AdAvAn/WaterLeak/(list of files, drawings)

Other design files:
pcb/PCB-print.eprj
pcb/PCB-print.json
