AdAvAn/WaterLeak/Buttons/HeaterButton.py

import Resources.Settings as Settings
from Buttons.ButtonPort import ButtonPort
from Buzzers.Buzzers import Buzzers
from Logging.AppLogger import AppLogger
from Heater.HeaterPowerSwith import HeaterPowerSwith
from State.States import States

class HeaterButton:
    
    def __init__(self, states: States, leak_sensors=None):
        self.buzzer = Buzzers()
        self.logger = AppLogger()
        self._port = ButtonPort(Settings.HOCB_PIN, self.callback)
        self.heater = HeaterPowerSwith(states)
        self.leak_sensors = leak_sensors 
        
    def start(self):
        self._port.start()

    def stop(self):
        self._port.stop()

    def callback(self, event: str) -> None:
        if event == ButtonPort.SHORT_EVENT_ID:
            self._short_handler()
        elif event == ButtonPort.LONG_EVENT_ID:
            self._long_handler()

    def _short_handler(self) -> None:
        # If alarm is active, any button press clears the alarm
        if self.leak_sensors:
            self.leak_sensors.clear()
            if self.leak_sensors.is_detected_leaks():
                return

        # Normal operation
        self.buzzer.control.play_confirm()
        self.heater.toggle()
        self.logger.info(f"BUTTONS: Heater toggled")

    def _long_handler(self) -> None:
        # If alarm is active, any button press clears the alarm
        if self.leak_sensors:
            self.leak_sensors.clear()
            return
