AdAvAn/WaterLeak/(commit log)

2025-09-10 Fix buttons clear alarm
    [HeaterButton.py, LeakSensors.py, ValveButtonsHandler.py, main.py]
2025-09-13 Add README.md
    [PCB-print.eprj, PCB-print.json]
